helpsss/qmk_firmware/keyboards/SplitArcade/readme.md

# Split Arcade

Split Arcade

An handwired dactyl manuform with a trackball on the right thumb cluster.

Keyboard Maintainer: [Alan](https://github.com/sbabborello)  
Hardware Supported: Arduino Pro Micro, ADNS9800 mouse sensor 

This keyborad is still in development, it will need some more iterations, but it is now in a state that other users can benefit.

What you will need for this build:

Arduino Pro Micro x2

Kailh hotswap sockets x45 (https://kbdfans.com/products/mechanical-keyboard-switches-kailh-pcb-socket) /optional

ADNS-9800 mouse sensor x1 (https://www.tindie.com/products/jkicklighter/adns-9800-laser-motion-sensor/)

34mm trackball x1 (https://www.amazon.ca/Perixx-18021-PERIPRO-303GR-Trackball-Compatible/dp/B071NX7Y2J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)

TRRS breakout board x2 (https://www.sparkfun.com/products/11570)

USB Micro breakout board x2 (https://www.adafruit.com/product/1833)

M2 12mm screws + bolts x2 (to secure the mouse sensor)

M2 6mm screws + blots x4 (to secure the usb breakout)

M3 10mm screws x12

M3 threaded inserts (https://www.amazon.com/a16041800ux0827-Cylindrical-Knurled-Threaded-Embedded/dp/B01IZ1RN0A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)

Si3N4 3mm balls (https://it.aliexpress.com/af/si3n4-bearings.html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) / these are needed to help the trackball glide inside its slot

Here's the project wiring:

wiring

in the stl folder you'll find the 3d models for the plates and the bases. 

------

I will provide photos of the final product and for some building steps

-----

Make example for this keyboard (after setting up your build environment):

    make SplitArcade:default

See the [build environment setup](https://docs.qmk.fm/#/getting_started_build_tools) and the [make instructions](https://docs.qmk.fm/#/getting_started_make_guide) for more information. Brand new to QMK? Start with our [Complete Newbs Guide](https://docs.qmk.fm/#/newbs).
