helpsss/qmk_firmware/keyboards/SplitArcade/L_SplitArcadeMK2_Base.stl

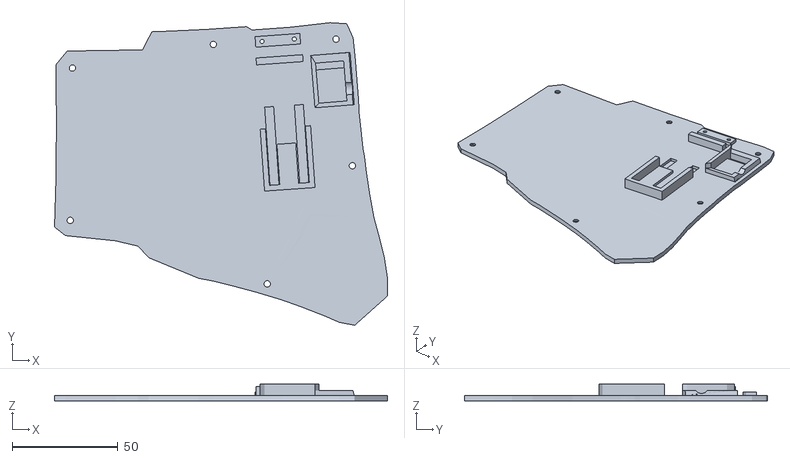
[picture p1: CAD file, 2020-03-14, last stored version]
keyboards/SplitArcade/L_SplitArcadeMK2_Base.stl
157.3 x 143.0 x 7.89
