helpsss/qmk_firmware/keyboards/SplitArcade/config.h

/*
Copyright 2019 Alan

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
You should have received a copy of the GNU General Public License
along with this program.  If not, see <http://www.gnu.org/licenses/>.
*/

#pragma once

#include "config_common.h"

/* USB Device descriptor parameter */
#define VENDOR_ID       0xFEED
#define PRODUCT_ID      0x0000
#define DEVICE_VER      0x0001
#define MANUFACTURER    Alan
#define PRODUCT         SplitArcade
#define DESCRIPTION     A custom keyboard

/* QMK Bootloader */


/* key matrix size */
#define MATRIX_ROWS 8
#define MATRIX_COLS 6

#define MATRIX_ROW_PINS { D2, D1, D4, C6 }
#define MATRIX_COL_PINS { F6, F5, F4, B4, E6, D7 }


/* COL2ROW, ROW2COL*/
#define DIODE_DIRECTION COL2ROW

/*
 * Split Keyboard specific options, make sure you have 'SPLIT_KEYBOARD = yes' in your rules.mk, and define SOFT_SERIAL_PIN.
 */
#define SOFT_SERIAL_PIN D3 // D0, D1, D2, D3 or E6

#define RGB_DI_PIN B5
#define RGBLED_NUM 46
//   #define RGBLIGHT_HUE_STEP 8
//   #define RGBLIGHT_SAT_STEP 8
//   #define RGBLIGHT_VAL_STEP 8
//   #define RGBLIGHT_LIMIT_VAL 255 /* The maximum brightness level */
//   #define RGBLIGHT_SLEEP  /* If defined, the RGB lighting will be switched off when the host goes to sleep */
// /*== all animations enable ==*/
//   #define RGBLIGHT_ANIMATIONS
// /*== or choose animations ==*/
//   #define RGBLIGHT_EFFECT_BREATHING
//   #define RGBLIGHT_EFFECT_RAINBOW_MOOD
//   #define RGBLIGHT_EFFECT_RAINBOW_SWIRL
//   #define RGBLIGHT_EFFECT_SNAKE
//   #define RGBLIGHT_EFFECT_KNIGHT
//   #define RGBLIGHT_EFFECT_CHRISTMAS
//   #define RGBLIGHT_EFFECT_STATIC_GRADIENT
//   #define RGBLIGHT_EFFECT_RGB_TEST
//   #define RGBLIGHT_EFFECT_ALTERNATING
// /*== customize breathing effect ==*/
//   /*==== (DEFAULT) use fixed table instead of exp() and sin() ====*/
//   #define RGBLIGHT_BREATHE_TABLE_SIZE 256      // 256(default) or 128 or 64
//   /*==== use exp() and sin() ====*/
//   #define RGBLIGHT_EFFECT_BREATHE_CENTER 1.85  // 1 to 2.7
//   #define RGBLIGHT_EFFECT_BREATHE_MAX    255   // 0 to 255
// #endif

//define NUMBER_OF_ENCODERS 1
//define ENCODERS_PAD_A {B2}
//define ENCODERS_PAD_B {B3}
//define ENCODER_RESOLUTION 1

#define TAP_CODE_DELAY 20

#define TAPPING_TERM 200

#define MASTER_RIGHT

#define DEBOUNCING_DELAY 5

/* Mechanical locking support. Use KC_LCAP, KC_LNUM or KC_LSCR instead in keymap */
#define LOCKING_SUPPORT_ENABLE
/* Locking resynchronize hack */
#define LOCKING_RESYNC_ENABLE
