helpsss/qmk_firmware/keyboards/SplitArcade/trackball.c

/* Copyright 2019 Alan
 *
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
 * You should have received a copy of the GNU General Public License
 * along with this program.  If not, see <http://www.gnu.org/licenses/>.
 */
#include "trackball.h"
#include "pointing_device.h"
#include "../../lib/lufa/LUFA/Drivers/Peripheral/SPI.h"
#include <avr/pgmspace.h>

#define SENSOR_CS B6

static const uint8_t MOTION = 0x02;
static const uint8_t DELTA_X_L = 0x03;
static const uint8_t DELTA_X_H = 0x04;
static const uint8_t DELTA_Y_L = 0x05;
static const uint8_t DELTA_Y_H = 0x06;
static const uint8_t CONFIG1 = 0x0F;
static const uint8_t CONFIG2 = 0x10;
static const uint8_t CONFIG4 = 0x39;
static const uint8_t SROM_ENABLE = 0x13;
static const uint8_t SROM_ID = 0x2A;
static const uint8_t POWER_UP_RESET = 0x3A;
static const uint8_t SHUTDOWN = 0x3B;
static const uint8_t MOTION_BURST = 0x50;
static const uint8_t SROM_LOAD_BURST = 0x62;
static const uint8_t LASER_CTRL = 0x20;

int8_t cpi;
int8_t newCPI;

const unsigned short firmware_length = 3070;

static const unsigned char firmware_data[] PROGMEM = {
0x03, 0xa6, 0x68, 0x1e, 0x7d, 0x10, 0x7e, 0x7e, 0x5f, 0x1c, 0xb8, 0xf2, 0x47, 0x0c, 0x7b,
0x74, 0x4b, 0x14, 0x8b, 0x75, 0x66, 0x51, 0x0b, 0x8c, 0x76, 0x74, 0x4b, 0x14, 0xaa, 0xd6,
0x0f, 0x9c, 0xba, 0xf6, 0x6e, 0x3f, 0xdd, 0x38, 0xd5, 0x02, 0x80, 0x9b, 0x82, 0x6d, 0x58,
0x13, 0xa4, 0xab, 0xb5, 0xc9, 0x10, 0xa2, 0xc6, 0x0a, 0x7f, 0x5d, 0x19, 0x91, 0xa0, 0xa3,
0xce, 0xeb, 0x3e, 0xc9, 0xf1, 0x60, 0x42, 0xe7, 0x4c, 0xfb, 0x74, 0x6a, 0x56, 0x2e, 0xbf,
0xdd, 0x38, 0xd3, 0x05, 0x88, 0x92, 0xa6, 0xce, 0xff, 0x5d, 0x38, 0xd1, 0xcf, 0xef, 0x58,
0xcb, 0x65, 0x48, 0xf0, 0x35, 0x85, 0xa9, 0xb2, 0x8f, 0x5e, 0xf3, 0x80, 0x94, 0x97, 0x7e,
0x75, 0x97, 0x87, 0x73, 0x13, 0xb0, 0x8a, 0x69, 0xd4, 0x0a, 0xde, 0xc1, 0x79, 0x59, 0x36,
0xdb, 0x9d, 0xd6, 0xb8, 0x15, 0x6f, 0xce, 0x3c, 0x72, 0x32, 0x45, 0x88, 0xdf, 0x6c, 0xa5,
0x6d, 0xe8, 0x76, 0x96, 0x14, 0x74, 0x20, 0xdc, 0xf4, 0xfa, 0x37, 0x6a, 0x27, 0x32, 0xe3,
0x29, 0xbf, 0xc4, 0xc7, 0x06, 0x9d, 0x58, 0xe7, 0x87, 0x7c, 0x2e, 0x9f, 0x6e, 0x49, 0x07,
0x5d, 0x23, 0x64, 0x54, 0x83, 0x6e, 0xcb, 0xb7, 0x77, 0xf7, 0x2b, 0x6e, 0x0f, 0x2e, 0x66,
0x12, 0x60, 0x55, 0x65, 0xfc, 0x43, 0xb3, 0x58, 0x73, 0x5b, 0xe8, 0x67, 0x04, 0x43, 0x02,
0xde, 0xb3, 0x89, 0xa0, 0x6d, 0x3a, 0x27, 0x79, 0x64, 0x5b, 0x0c, 0x16, 0x9e, 0x66, 0xb1,
0x8b, 0x87, 0x0c, 0x5d, 0xf2, 0xb6, 0x3d, 0x71, 0xdf, 0x42, 0x03, 0x8a, 0x06, 0x8d, 0xef,
0x1d, 0xa8, 0x96, 0x5c, 0xed, 0x31, 0x61, 0x5c, 0xa1, 0x34, 0xf6, 0x8c, 0x08, 0x60, 0x33,
0x07, 0x00, 0x3e, 0x79, 0x95, 0x1b, 0x43, 0x7f, 0xfe, 0xb6, 0xa6, 0xd4, 0x9d, 0x76, 0x72,
0xbf, 0xad, 0xc0, 0x15, 0xe8, 0x37, 0x31, 0xa3, 0x72, 0x63, 0x52, 0x1d, 0x1c, 0x5d, 0x51,
0x1b, 0xe1, 0xa9, 0xed, 0x60, 0x32, 0x3e, 0xa9, 0x50, 0x28, 0x53, 0x06, 0x59, 0xe2, 0xfc,
0xe7, 0x02, 0x64, 0x39, 0x21, 0x56, 0x4a, 0xa5, 0x40, 0x80, 0x81, 0xd5, 0x5a, 0x60, 0x7b,
0x68, 0x84, 0xf1, 0xe0, 0xb1, 0xb6, 0x5b, 0xdf, 0xa8, 0x1d, 0x6d, 0x65, 0x20, 0xc0, 0xa2,
0xb9, 0xd9, 0xbb, 0x00, 0xa6, 0xdb, 0x8b, 0x01, 0x53, 0x91, 0xfe, 0xc4, 0x51, 0x85, 0xb0,
0x96, 0x7f, 0xfd, 0x51, 0xdd, 0x14, 0x03, 0x67, 0x2e, 0x75, 0x1c, 0x76, 0xd3, 0x6e, 0xdd,
0x99, 0x55, 0x76, 0xe5, 0xab, 0x23, 0xfc, 0x4a, 0xd5, 0xc6, 0xe8, 0x2e, 0xca, 0x8a, 0xb3,
0xf6, 0x8c, 0x6c, 0xb0, 0xe9, 0xf2, 0xe7, 0x9e, 0x69, 0x41, 0xed, 0xf1, 0x6d, 0xd2, 0x86,
0xd8, 0x7e, 0xcb, 0x5d, 0x47, 0x6c, 0x85, 0x6a, 0x23, 0xed, 0x20, 0x40, 0x93, 0xb4, 0x20,
0xc7, 0xa5, 0xc9, 0xaf, 0x03, 0x15, 0xac, 0x19, 0xe5, 0x2a, 0x36, 0xdf, 0x6d, 0xc5, 0x8c,
0x80, 0x07, 0xce, 0x92, 0x0c, 0xd8, 0x06, 0x62, 0x0f, 0xdd, 0x48, 0x46, 0x1a, 0x53, 0xc7,
0x8a, 0x8c, 0x5d, 0x5d, 0xb4, 0xa1, 0x02, 0xd3, 0xa9, 0xb8, 0xf3, 0x94, 0x8f, 0x3f, 0xe5,
0x54, 0xd4, 0x11, 0x65, 0xb2, 0x5e, 0x09, 0x0b, 0x81, 0xe3, 0x75, 0xa7, 0x89, 0x81, 0x39,
0x6c, 0x46, 0xf6, 0x06, 0x9f, 0x27, 0x3b, 0xb6, 0x2d, 0x5f, 0x1d, 0x4b, 0xd4, 0x7b, 0x1d,
0x61, 0x74, 0x89, 0xe4, 0xe3, 0xbd, 0x98, 0x1b, 0xc4, 0x51, 0x3b, 0xa4, 0xfa, 0xe0, 0x92,
0xf7, 0xbe, 0xf2, 0x4d, 0xbb, 0xff, 0xad, 0x4f, 0x6d, 0x68, 0xc2, 0x79, 0x40, 0xaa, 0x9b,
0x8f, 0x0c, 0x32, 0x4b, 0x5f, 0x3e, 0xab, 0x59, 0x98, 0xb3, 0xf5, 0x1d, 0xac, 0x5e, 0xbc,
0x78, 0xd3, 0x01, 0x6c, 0x64, 0x15, 0x2f, 0xd8, 0x71, 0xa6, 0x2d, 0x45, 0xe1, 0x22, 0x42,
0xe4, 0x4e, 0x04, 0x3c, 0x7d, 0xf4, 0x40, 0x21, 0xb4, 0x67, 0x05, 0xa8, 0xe2, 0xf3, 0x72,
0x87, 0x4c, 0x7d, 0xd9, 0x1b, 0x65, 0x97, 0xf3, 0xc2, 0xe3, 0xe4, 0xc8, 0xd2, 0xde, 0xf6,
0xef, 0xdc, 0xbb, 0x44, 0x08, 0x5e, 0xe2, 0x45, 0x27, 0x01, 0xb0, 0xf6, 0x43, 0xe7, 0x3a,
0xf6, 0xdc, 0x9d, 0xed, 0xf3, 0xc5, 0x0c, 0xb8, 0x9c, 0x98, 0x3a, 0xd8, 0x36, 0xee, 0x96,
0x72, 0x67, 0xe7, 0x81, 0x91, 0xd5, 0x05, 0x0a, 0xe0, 0x82, 0xd5, 0x8f, 0xe8, 0xf9, 0xb0,
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



void adnsComBegin(void) { writePinLow(SENSOR_CS); }

void adnsComEnd(void) { writePinHigh(SENSOR_CS); }

uint8_t adnsReadReg(uint8_t reg_addr) {
    adnsComBegin();

    // send adress of the register, with MSBit = 0 to indicate it's a read
    SPI_TransferByte(reg_addr & 0x7f);
    wait_us(100);  // tSRAD
    uint8_t data = SPI_TransferByte(0);

    // tSCLK-SENSOR_CS for read operation is 120ns
    wait_us(1);
    adnsComEnd();
    // tSRW/tSRR (=20us) minus tSCLK-SENSOR_CS
    wait_us(19);

    return data;
}

void adnsWriteReg(uint8_t reg_addr, uint8_t data) {
    adnsComBegin();

    // send adress of the register, with MSBit = 1 to indicate it's a write
    SPI_TransferByte(reg_addr | 0x80);
    SPI_TransferByte(data);

    wait_us(20); // tSCLK-SENSOR_CS for write operation
    adnsComEnd();
    wait_us(100);  // tSWW/tSWR (=120us) minus tSCLK-SENSOR_CS.
}

void firmware_upload(void) {
     
    adnsWriteReg(CONFIG4, 0x02); // set the CONFIG4 register in 3k firmware mode

    adnsWriteReg(SROM_ENABLE, 0x1d);  // write 0x1d in SROM_enable reg for initializing

    // wait for more than one frame period
    // assume that the frame rate is as low as 100fps, even if it should never be that low
    wait_ms(10);

    // write 0x18 to SROM_enable to start SROM download
    adnsWriteReg(SROM_ENABLE, 0x18);

    // write burst destination adress
    adnsComBegin();
    SPI_TransferByte(SROM_LOAD_BURST | 0x80);
    wait_us(15);

    unsigned char c;
    for (uint16_t i = 0; i < firmware_length; i++) {
        c = (unsigned char)pgm_read_byte(firmware_data + i);
        SPI_TransferByte(c);
        wait_us(15);
	}
	adnsComEnd();
	
}

void startUp(void) {
	
	// Hard reset. Start by ensuring that the serial port is reset.
    adnsComEnd();
    adnsComBegin();
    adnsComEnd();
	adnsWriteReg(POWER_UP_RESET, 0x5a); // Force a reset of the ADNS9800.
    wait_ms(50);

    // Read registers 0x02 through 0x06 (and discard the data)
    adnsReadReg(MOTION);
    adnsReadReg(DELTA_X_L);
    adnsReadReg(DELTA_X_H);
    adnsReadReg(DELTA_Y_L);
    adnsReadReg(DELTA_Y_H);

	firmware_upload();

    wait_ms(10);
	uint8_t LASER = adnsReadReg(LASER_CTRL);
	adnsWriteReg(LASER_CTRL, LASER & 0xF0);
    adnsWriteReg(CONFIG1, 0x12);
    wait_ms(1);

 }

__attribute__((weak)) void RES_UP(void) {

cpi = adnsReadReg(CONFIG1);
newCPI = cpi + 0x01;
adnsWriteReg(CONFIG1, newCPI);

}

__attribute__((weak)) void RES_DOWN(void) {

cpi = adnsReadReg(CONFIG1);
newCPI = cpi - 0x01;
adnsWriteReg(CONFIG1, newCPI);

}

int16_t convertDeltaToInt(uint8_t high, uint8_t low){

    // join bytes into twos compliment
    uint16_t twos_comp = (high << 8) | low;

    // convert twos comp to int
    if (twos_comp & 0x8000)
        return -1 * ((twos_comp ^ 0xffff) + 1);

    return twos_comp;
}

void pointing_device_init(void) {
	
	setPinOutput(SENSOR_CS);

	SPI_Init(SPI_SPEED_FCPU_DIV_8 | SPI_SCK_LEAD_FALLING | SPI_SAMPLE_TRAILING | SPI_ORDER_MSB_FIRST | SPI_MODE_MASTER);
	
	startUp();
	
}

void pointing_device_task(void){
	
	dx = convertDeltaToInt(adnsReadReg(DELTA_X_H), adnsReadReg(DELTA_X_L));
	
	dy = convertDeltaToInt(adnsReadReg(DELTA_Y_H), adnsReadReg(DELTA_Y_L));
	
	report_mouse_t currentReport = pointing_device_get_report();

	currentReport.x = -dx;
	currentReport.y = dy;
	
	pointing_device_set_report(currentReport);
    
	pointing_device_send();
}
